FBIopeningUPP/corne-ulp/production/bom.csv

Designator | Footprint | Quantity | Value | LCSC Part #
C1, C101, C104, C105, C4, C5 | 0603 | 6 | 100n
C102, C109, C2, C9 | 0603 | 4 | 2.2uF
C103, C3 | CAP-SMD_L1.6-W0.8-RD | 2 | 4.7uF 6.3V polymer tantalum | C2158419
C106, C107, C6, C7 | 0402 | 4 | 1uF
C108, C8 | 0402 | 2 | 560pF
D1, D101 | SOD-323_L1.7-W1.3-LS2.7-RD | 2 | 1N5819WS | C489147
D10, D102, D103, D104, D105, D106, D107, D108, D109, D11, D110, D111, D112, D113, D114, D115, D116, D117, D118, D119, D12, D120, D121, D122, D13, D14, D15, D16, D17, D18, D19, D2, D20, D21, D22, D3, D4, D5, D6, D7, D8, D9 | SOD-523_L1.2-W0.8-LS1.6-RD | 42 | 1N4148WT-7 | C83482
J1, J101 | FFC-SMD_10P-P0.50_FH34SRJ-10S-0.5SH | 2 | LS011B7DH03_FPC | C324723
OSC1, OSC101 | OSC-SMD_4P-L3.2-W1.5 | 2 | X1B0002110001 | C256005
Q102, Q2 | SOT-23-3_L3.0-W1.7-P0.95-LS2.9-BR | 2 | AO3407 | C351408
R1, R101, R102, R2 | 0402 | 4 | 5.1k
R103, R108, R3, R8 | 0402 | 4 | 100k
R104, R4 | 0402 | 2 | 33.2k
R106, R107, R6, R7 | 0402 | 4 | 820k
SW1, SW10, SW101, SW102, SW103, SW104, SW105, SW106, SW107, SW108, SW109, SW11, SW110, SW111, SW112, SW113, SW114, SW115, SW116, SW117, SW118, SW119, SW12, SW120, SW121, SW13, SW14, SW15, SW16, SW17, SW18, SW19, SW2, SW20, SW21, SW3, SW4, SW5, SW6, SW7, SW8, SW9 | Cherry_ULP_SMD | 42 | Cherry_ULP_SMD
TP1 | TestPoint_Pad_D1.5mm | 1 | L_VDD_SYS
TP101 | TestPoint_Pad_D1.5mm | 1 | R_VDD_SYS
TP102 | TestPoint_Pad_D1.5mm | 1 | R_GND
TP103 | TestPoint_Pad_D1.5mm | 1 | R_SWDIO
TP104 | TestPoint_Pad_D1.5mm | 1 | R_SWDCLK
TP105 | TestPoint_Pad_D1.5mm | 1 | R_RESET
TP106 | TestPoint_Pad_D2.0mm | 1 | R_VBAT
TP107 | TestPoint_Pad_D2.0mm | 1 | R_GND
TP2 | TestPoint_Pad_D1.5mm | 1 | L_GND
TP3 | TestPoint_Pad_D1.5mm | 1 | L_SWDIO
TP4 | TestPoint_Pad_D1.5mm | 1 | L_SWDCLK
TP5 | TestPoint_Pad_D1.5mm | 1 | L_RESET
TP6 | TestPoint_Pad_D2.0mm | 1 | L_VBAT
TP7 | TestPoint_Pad_D2.0mm | 1 | L_GND
U1, U101 | WIRELM-SMD_E73-2G4M08S1C | 2 | E73-2G4M08S1C | C356849
U102, U2 | SOT-23-5_L3.0-W1.7-P0.95-LS2.8-BL | 2 | TP4054 | C32574
U103, U3 | SOT-23-5 | 2 | MIC5219-3.0YM5
USB1, USB101 | USB-C-SMD_SHOU_TYPE-C-16P-CB1.6 | 2 | TYPE-C 16P CB1.6 073 | C2906290
