FBIopeningUPP/corne-ulp/JOURNAL.md

---
title: "aerix-ulp"
author: "I AM LITREALLY FBI"
description: "AERIX-ULP is a low-profile split mechanical keyboard with a custom layout. It is designed around Cherry MX Ultra Low Profile switches and uses a separate wireless controller and battery-powered electronics on each half."
created_at: "2026-11-10"
---

# 2026-11-10: finish

**Total time spent: 1 hr**




design part is done took time but is nice and all and the  keyboard is slim and all and simple witht the enough features

# 2026-11-10: laying out

**Total time spent: 1.5h**



layed out all the components saw some posts on kbd.news saw some keyboard figured out how i will llayout my keys so did it figured out where i place my lcb and what battery i will use and all and figued out how i want my edge cuts to look like and all 





made the schematic nice and all

# 2026-11-10: schematic finished

**Total time spent: 1 hour**





made the default scheamtic i went with nrf52840 and the sharp display as the nicevew and nice nano uses the same and corne ulp as it is the thinnest possible mechancial switches in excistense and tp4054 as it is nice to wire it and many nrf micro like boards ship with it and i went with those already in the pcb like half dipped type type c ports so it stays thin and all i already have designed nrf52840 boards so it was easy and sharp has a nice everything so everything done easily and i have worked on keyboard so the matrix was done fast next i will do the pcb
