FBIopeningUPP/corne-ulp/hardware/split/split.kicad_pcb

## KiCad design hardware/split/split.kicad_pcb (2026-11-10)

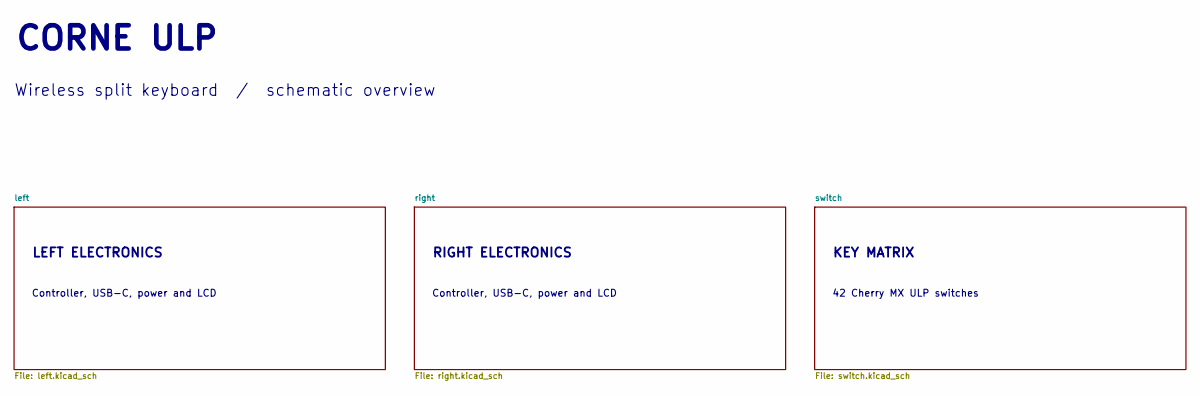
[picture p6: schematic split.kicad_sch]

Notes on the sheet:
Controller, USB-C, power and LCD
CORNE ULP
42 Cherry MX ULP switches
Wireless split keyboard / schematic overview
RIGHT ELECTRONICS
LEFT ELECTRONICS
KEY MATRIX

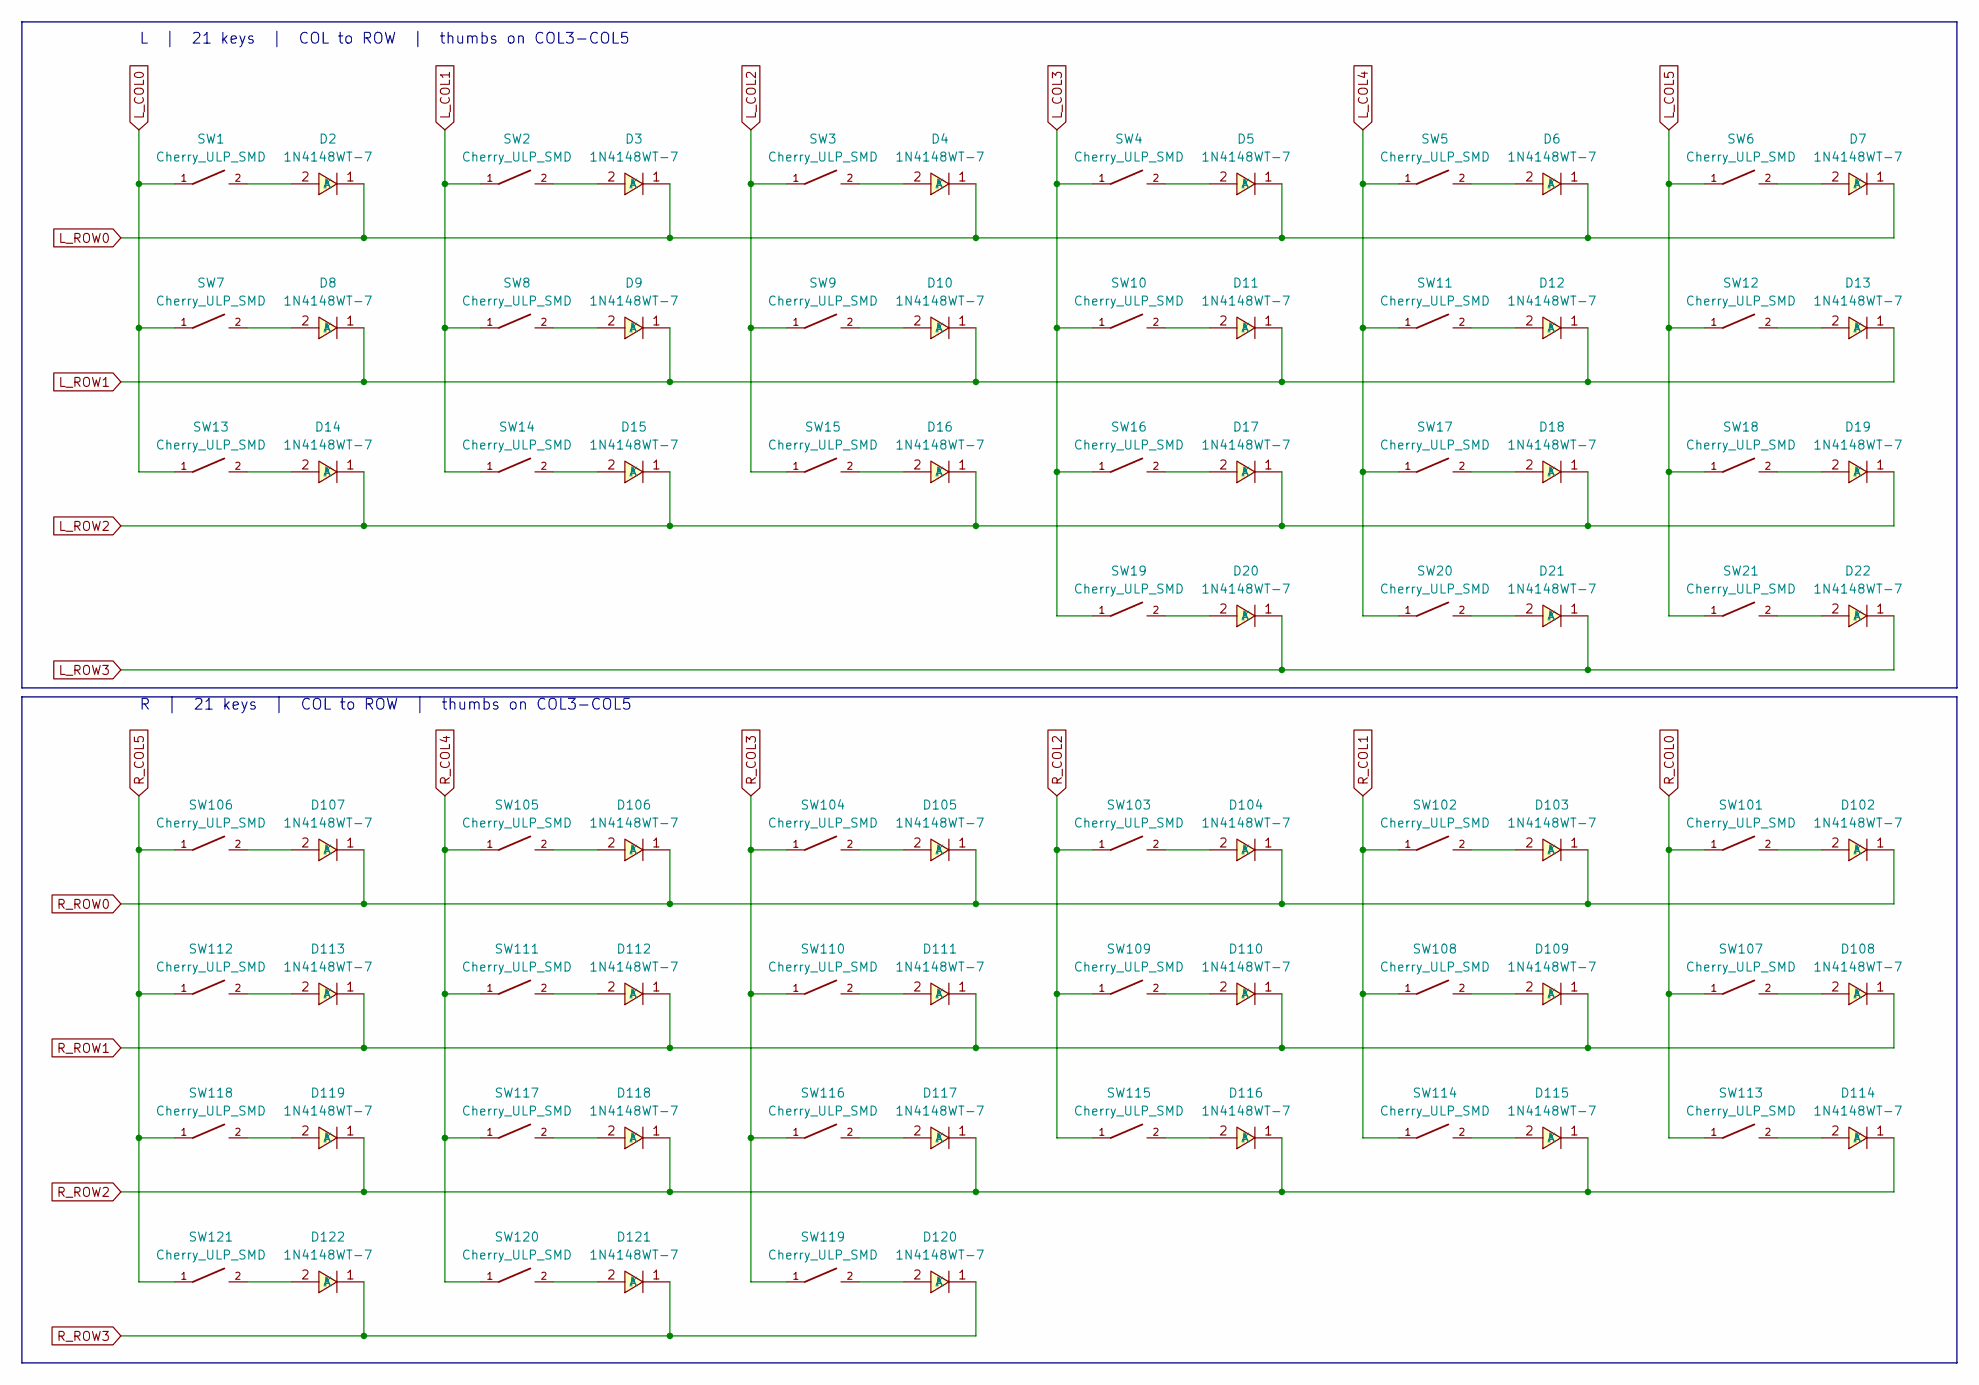
[picture p7: schematic switch.kicad_sch]

Parts:
D2, D3, D4, D5, D6, D7, D8, D9, D10, D11, D12, D13, D14, D15, D16, D17, D18, D19, D20, D21, D22, D102, D103, D104, D105, D106, D107, D108, D109, D110, D111, D112, D113, D114, D115, D116, D117, D118, D119, D120, D121, D122: 1N4148WT-7; SOD-523_L1.2-W0.8-LS1.6-RD
SW1, SW2, SW3, SW4, SW5, SW6, SW7, SW8, SW9, SW10, SW11, SW12, SW13, SW14, SW15, SW16, SW17, SW18, SW19, SW20, SW21, SW101, SW102, SW103, SW104, SW105, SW106, SW107, SW108, SW109, SW110, SW111, SW112, SW113, SW114, SW115, SW116, SW117, SW118, SW119, SW120, SW121: Cherry_ULP_SMD

Connections:
L_COL0: SW1.1, SW7.1, SW13.1; also elsewhere on the board
L_COL1: SW2.1, SW8.1, SW14.1; also elsewhere on the board
L_COL2: SW3.1, SW9.1, SW15.1; also elsewhere on the board
L_COL3: SW4.1, SW10.1, SW16.1, SW19.1; also elsewhere on the board
L_COL4: SW5.1, SW11.1, SW17.1, SW20.1; also elsewhere on the board
L_COL5: SW6.1, SW12.1, SW18.1, SW21.1; also elsewhere on the board
L_ROW0: D2.1 (K), D3.1 (K), D4.1 (K), D5.1 (K), D6.1 (K), D7.1 (K); also elsewhere on the board
L_ROW1: D8.1 (K), D9.1 (K), D10.1 (K), D11.1 (K), D12.1 (K), D13.1 (K); also elsewhere on the board
L_ROW2: D14.1 (K), D15.1 (K), D16.1 (K), D17.1 (K), D18.1 (K), D19.1 (K); also elsewhere on the board
L_ROW3: D20.1 (K), D21.1 (K), D22.1 (K); also elsewhere on the board
unnamed: D2.2 (A), SW1.2
unnamed: D3.2 (A), SW2.2
unnamed: D4.2 (A), SW3.2
unnamed: D5.2 (A), SW4.2
unnamed: D6.2 (A), SW5.2
unnamed: D7.2 (A), SW6.2
unnamed: D8.2 (A), SW7.2
unnamed: D9.2 (A), SW8.2
unnamed: D10.2 (A), SW9.2
unnamed: D11.2 (A), SW10.2
unnamed: D12.2 (A), SW11.2
unnamed: D13.2 (A), SW12.2
unnamed: D14.2 (A), SW13.2
unnamed: D15.2 (A), SW14.2
unnamed: D16.2 (A), SW15.2
unnamed: D17.2 (A), SW16.2
unnamed: D18.2 (A), SW17.2
unnamed: D19.2 (A), SW18.2
unnamed: D20.2 (A), SW19.2
unnamed: D21.2 (A), SW20.2
unnamed: D22.2 (A), SW21.2
unnamed: D102.2 (A), SW101.2
unnamed: D103.2 (A), SW102.2
unnamed: D104.2 (A), SW103.2
unnamed: D105.2 (A), SW104.2
unnamed: D106.2 (A), SW105.2
unnamed: D107.2 (A), SW106.2
unnamed: D108.2 (A), SW107.2
unnamed: D109.2 (A), SW108.2
unnamed: D110.2 (A), SW109.2
unnamed: D111.2 (A), SW110.2
unnamed: D112.2 (A), SW111.2
unnamed: D113.2 (A), SW112.2
unnamed: D114.2 (A), SW113.2
unnamed: D115.2 (A), SW114.2
unnamed: D116.2 (A), SW115.2
unnamed: D117.2 (A), SW116.2
unnamed: D118.2 (A), SW117.2
unnamed: D119.2 (A), SW118.2
unnamed: D120.2 (A), SW119.2
unnamed: D121.2 (A), SW120.2
unnamed: D122.2 (A), SW121.2
R_COL0: SW101.1, SW107.1, SW113.1; also elsewhere on the board
R_COL1: SW102.1, SW108.1, SW114.1; also elsewhere on the board
R_COL2: SW103.1, SW109.1, SW115.1; also elsewhere on the board
R_COL3: SW104.1, SW110.1, SW116.1, SW119.1; also elsewhere on the board
R_COL4: SW105.1, SW111.1, SW117.1, SW120.1; also elsewhere on the board
R_COL5: SW106.1, SW112.1, SW118.1, SW121.1; also elsewhere on the board
R_ROW0: D102.1 (K), D103.1 (K), D104.1 (K), D105.1 (K), D106.1 (K), D107.1 (K); also elsewhere on the board
R_ROW1: D108.1 (K), D109.1 (K), D110.1 (K), D111.1 (K), D112.1 (K), D113.1 (K); also elsewhere on the board
R_ROW2: D114.1 (K), D115.1 (K), D116.1 (K), D117.1 (K), D118.1 (K), D119.1 (K); also elsewhere on the board
R_ROW3: D120.1 (K), D121.1 (K), D122.1 (K); also elsewhere on the board

Notes on the sheet:
L | 21 keys | COL to ROW | thumbs on COL3-COL5
R | 21 keys | COL to ROW | thumbs on COL3-COL5

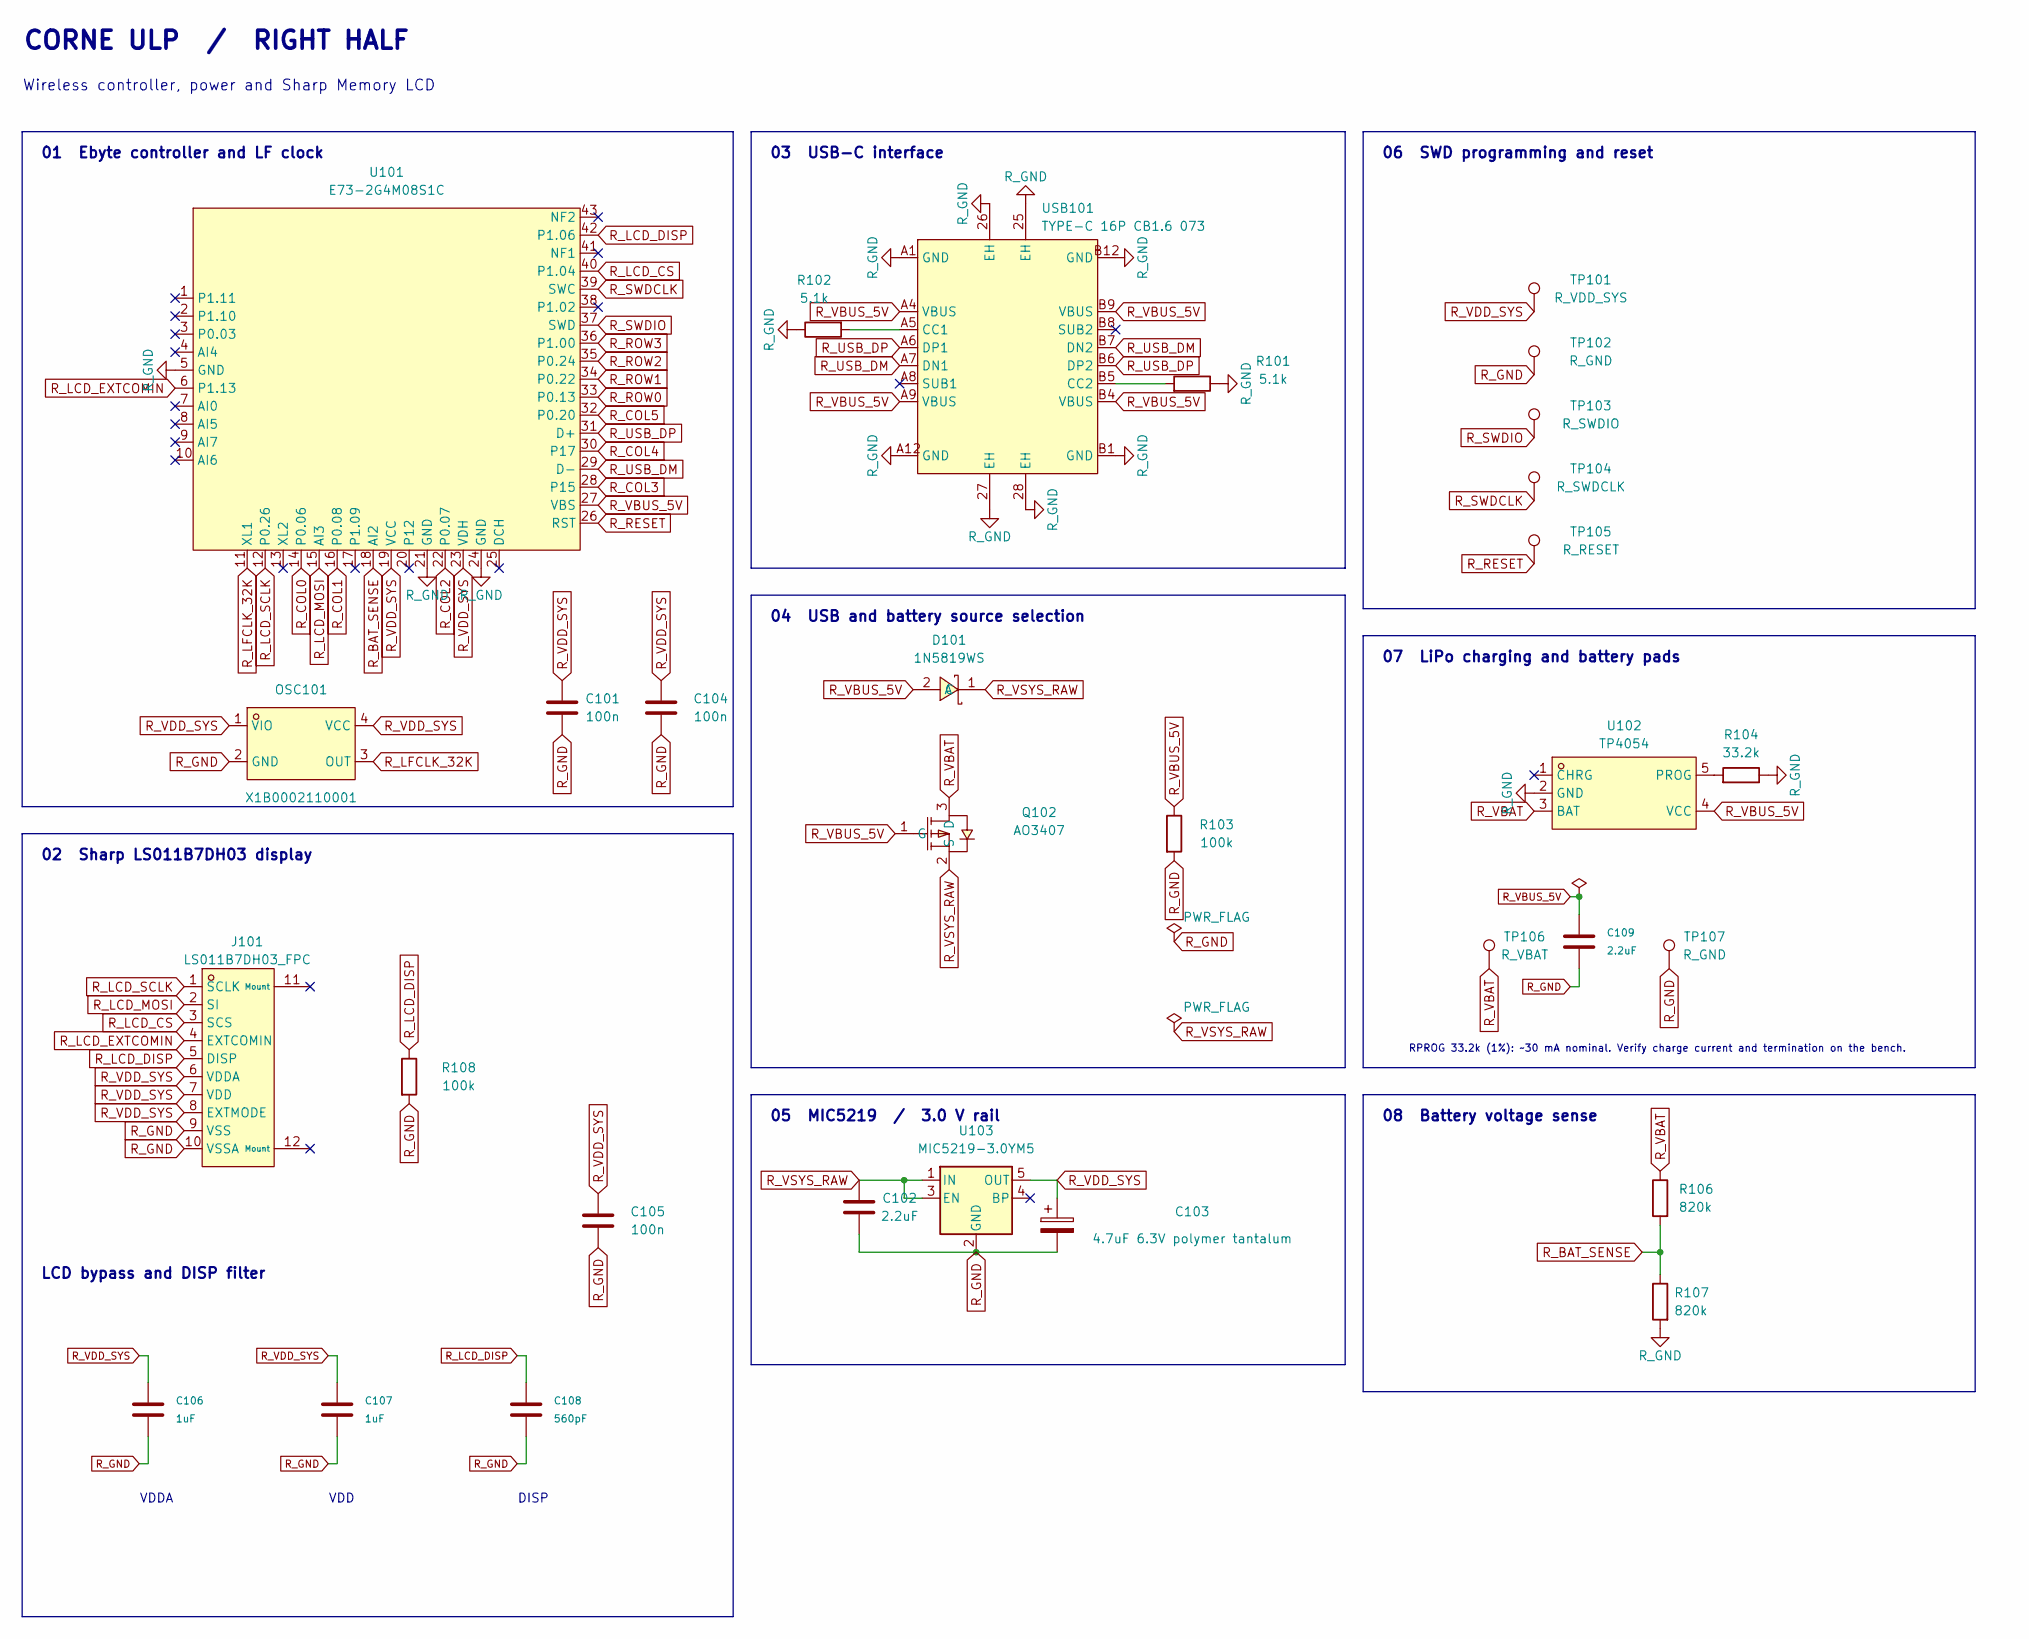
[picture p8: schematic right.kicad_sch]

Parts:
C101, C104, C105: 100n; C_0603_1608Metric
C102, C109: 2.2uF; C_0603_1608Metric
C103: 4.7uF 6.3V polymer tantalum; CAP-SMD_L1.6-W0.8-RD; MPN T55J475M6R3C0500
C106, C107: 1uF; C_0402_1005Metric
C108: 560pF; C_0402_1005Metric
D101: 1N5819WS; SOD-323_L1.7-W1.3-LS2.7-RD
J101: LS011B7DH03_FPC; FFC-SMD_10P-P0.50_FH34SRJ-10S-0.5SH
OSC101: X1B0002110001; OSC-SMD_4P-L3.2-W1.5
Q102: AO3407; SOT-23-3_L3.0-W1.7-P0.95-LS2.9-BR
R101, R102: 5.1k; R_0402_1005Metric
R103, R108: 100k; R_0402_1005Metric
R104: 33.2k; R_0402_1005Metric
R106, R107: 820k; R_0402_1005Metric
TP101: R_VDD_SYS; TestPoint_Pad_D1.5mm
TP102: R_GND; TestPoint_Pad_D1.5mm
TP103: R_SWDIO; TestPoint_Pad_D1.5mm
TP104: R_SWDCLK; TestPoint_Pad_D1.5mm
TP105: R_RESET; TestPoint_Pad_D1.5mm
TP106: R_VBAT; TestPoint_Pad_D2.0mm
TP107: R_GND; TestPoint_Pad_D2.0mm
U101: E73-2G4M08S1C; WIRELM-SMD_E73-2G4M08S1C; MPN E73-2G4M08S1C; LCSC Part C356849
U102: TP4054; SOT-23-5_L3.0-W1.7-P0.95-LS2.8-BL; MPN TP4054-42-SOT25R; LCSC Part C32574
U103: MIC5219-3.0YM5; SOT-23-5
USB101: TYPE-C 16P CB1.6 073; USB-C-SMD_SHOU_TYPE-C-16P-CB1.6; MPN TYPE-C 16P CB1.6 073; LCSC Part C2906290

Connections:
unnamed: R104.1, U102.5 (PROG)
unnamed: R102.1, USB101.A5 (CC1)
unnamed: R101.1, USB101.B5 (CC2)
R_BAT_SENSE: R106.1, R107.2, U101.18 (AI2)
R_COL0: U101.14 (P0.06); also elsewhere on the board
R_COL1: U101.16 (P0.08); also elsewhere on the board
R_COL2: U101.22 (P0.07); also elsewhere on the board
R_COL3: U101.28 (P15); also elsewhere on the board
R_COL4: U101.30 (P17); also elsewhere on the board
R_COL5: U101.32 (P0.20); also elsewhere on the board
R_GND: C101.2, C102.2, C103.2, C104.2, C105.2, C106.2, C107.2, C108.2, C109.2, J101.9 (VSS), J101.10 (VSSA), OSC101.2 (GND), R101.2, R102.2, R103.2, R104.2, R107.1, R108.2, TP102.1 (1_1), TP107.1 (1_1), U101.5 (GND), U101.21 (GND), U101.24 (GND), U102.2 (GND), U103.2 (GND), USB101.25 (EH), USB101.26 (EH), USB101.27 (EH), USB101.28 (EH), USB101.A1 (GND), USB101.A12 (GND), USB101.B1 (GND), USB101.B12 (GND)
R_LCD_CS: J101.3 (SCS), U101.40 (P1.04)
R_LCD_DISP: C108.1, J101.5 (DISP), R108.1, U101.42 (P1.06)
R_LCD_EXTCOMIN: J101.4 (EXTCOMIN), U101.6 (P1.13)
R_LCD_MOSI: J101.2 (SI), U101.15 (AI3)
R_LCD_SCLK: J101.1 (SCLK), U101.12 (P0.26)
R_LFCLK_32K: OSC101.3 (OUT), U101.11 (XL1)
R_RESET: TP105.1 (1_1), U101.26 (RST)
R_ROW0: U101.33 (P0.13); also elsewhere on the board
R_ROW1: U101.34 (P0.22); also elsewhere on the board
R_ROW2: U101.35 (P0.24); also elsewhere on the board
R_ROW3: U101.36 (P1.00); also elsewhere on the board
R_SWDCLK: TP104.1 (1_1), U101.39 (SWC)
R_SWDIO: TP103.1 (1_1), U101.37 (SWD)
R_USB_DM: U101.29 (D-), USB101.A7 (DN1), USB101.B7 (DN2)
R_USB_DP: U101.31 (D+), USB101.A6 (DP1), USB101.B6 (DP2)
R_VBAT: Q102.3 (D), R106.2, TP106.1 (1_1), U102.3 (BAT)
R_VBUS_5V: C109.1, D101.2 (A), Q102.1 (G), R103.1, U101.27 (VBS), U102.4 (VCC), USB101.A4 (VBUS), USB101.A9 (VBUS), USB101.B4 (VBUS), USB101.B9 (VBUS)
R_VDD_SYS: C101.1, C103.1, C104.1, C105.1, C106.1, C107.1, J101.6 (VDDA), J101.7 (VDD), J101.8 (EXTMODE), OSC101.1 (VIO), OSC101.4 (VCC), TP101.1 (1_1), U101.19 (VCC), U101.23 (VDH), U103.5 (OUT)
R_VSYS_RAW: C102.1, D101.1 (C), Q102.2 (S), U103.1 (IN), U103.3 (EN)

Notes on the sheet:
06 SWD programming and reset
VDD
04 USB and battery source selection
LCD bypass and DISP filter
02 Sharp LS011B7DH03 display
08 Battery voltage sense
Wireless controller, power and Sharp Memory LCD
01 Ebyte controller and LF clock
VDDA
03 USB-C interface
DISP
RPROG 33.2k (1%): ~30 mA nominal. Verify charge current and termination on the bench.
CORNE ULP / RIGHT HALF
07 LiPo charging and battery pads
05 MIC5219 / 3.0 V rail

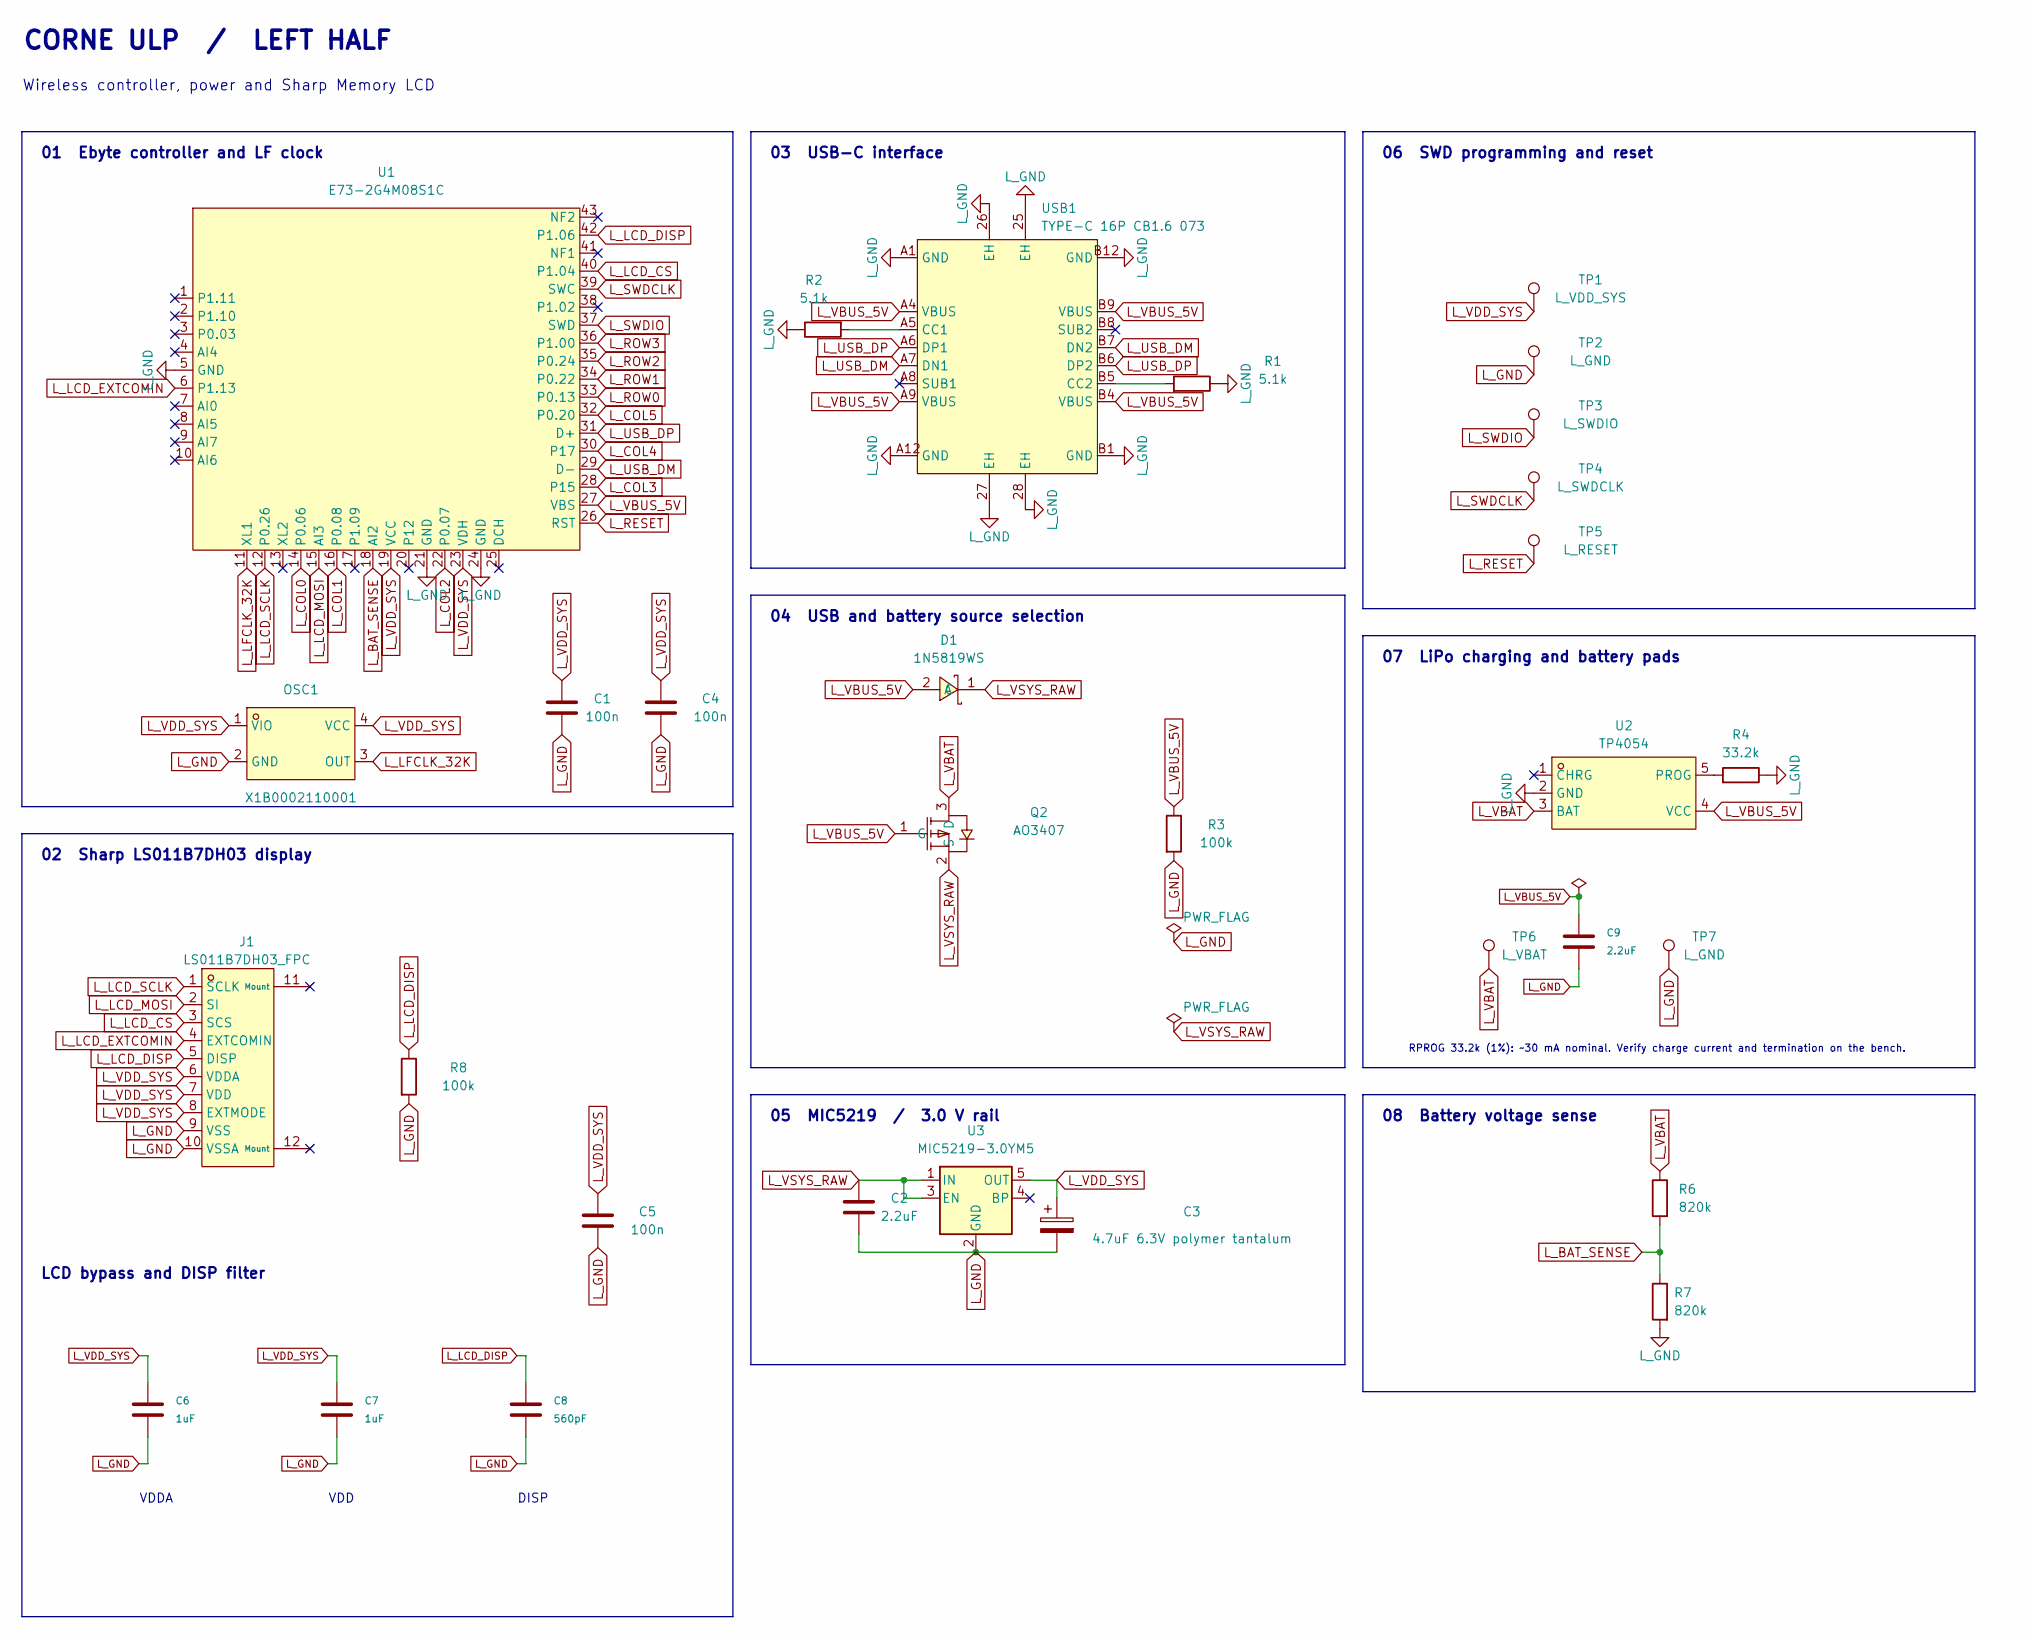
[picture p9: schematic left.kicad_sch]

Parts:
C1, C4, C5: 100n; C_0603_1608Metric
C2, C9: 2.2uF; C_0603_1608Metric
C3: 4.7uF 6.3V polymer tantalum; CAP-SMD_L1.6-W0.8-RD; MPN T55J475M6R3C0500
C6, C7: 1uF; C_0402_1005Metric
C8: 560pF; C_0402_1005Metric
D1: 1N5819WS; SOD-323_L1.7-W1.3-LS2.7-RD
J1: LS011B7DH03_FPC; FFC-SMD_10P-P0.50_FH34SRJ-10S-0.5SH
OSC1: X1B0002110001; OSC-SMD_4P-L3.2-W1.5
Q2: AO3407; SOT-23-3_L3.0-W1.7-P0.95-LS2.9-BR
R1, R2: 5.1k; R_0402_1005Metric
R3, R8: 100k; R_0402_1005Metric
R4: 33.2k; R_0402_1005Metric
R6, R7: 820k; R_0402_1005Metric
TP1: L_VDD_SYS; TestPoint_Pad_D1.5mm
TP2: L_GND; TestPoint_Pad_D1.5mm
TP3: L_SWDIO; TestPoint_Pad_D1.5mm
TP4: L_SWDCLK; TestPoint_Pad_D1.5mm
TP5: L_RESET; TestPoint_Pad_D1.5mm
TP6: L_VBAT; TestPoint_Pad_D2.0mm
TP7: L_GND; TestPoint_Pad_D2.0mm
U1: E73-2G4M08S1C; WIRELM-SMD_E73-2G4M08S1C; MPN E73-2G4M08S1C; LCSC Part C356849
U2: TP4054; SOT-23-5_L3.0-W1.7-P0.95-LS2.8-BL; MPN TP4054-42-SOT25R; LCSC Part C32574
U3: MIC5219-3.0YM5; SOT-23-5
USB1: TYPE-C 16P CB1.6 073; USB-C-SMD_SHOU_TYPE-C-16P-CB1.6; MPN TYPE-C 16P CB1.6 073; LCSC Part C2906290

Connections:
L_BAT_SENSE: R6.1, R7.2, U1.18 (AI2)
L_COL0: U1.14 (P0.06); also elsewhere on the board
L_COL1: U1.16 (P0.08); also elsewhere on the board
L_COL2: U1.22 (P0.07); also elsewhere on the board
L_COL3: U1.28 (P15); also elsewhere on the board
L_COL4: U1.30 (P17); also elsewhere on the board
L_COL5: U1.32 (P0.20); also elsewhere on the board
L_GND: C1.2, C2.2, C3.2, C4.2, C5.2, C6.2, C7.2, C8.2, C9.2, J1.9 (VSS), J1.10 (VSSA), OSC1.2 (GND), R1.2, R2.2, R3.2, R4.2, R7.1, R8.2, TP2.1 (1_1), TP7.1 (1_1), U1.5 (GND), U1.21 (GND), U1.24 (GND), U2.2 (GND), U3.2 (GND), USB1.25 (EH), USB1.26 (EH), USB1.27 (EH), USB1.28 (EH), USB1.A1 (GND), USB1.A12 (GND), USB1.B1 (GND), USB1.B12 (GND)
L_LCD_CS: J1.3 (SCS), U1.40 (P1.04)
L_LCD_DISP: C8.1, J1.5 (DISP), R8.1, U1.42 (P1.06)
L_LCD_EXTCOMIN: J1.4 (EXTCOMIN), U1.6 (P1.13)
L_LCD_MOSI: J1.2 (SI), U1.15 (AI3)
L_LCD_SCLK: J1.1 (SCLK), U1.12 (P0.26)
L_LFCLK_32K: OSC1.3 (OUT), U1.11 (XL1)
L_RESET: TP5.1 (1_1), U1.26 (RST)
L_ROW0: U1.33 (P0.13); also elsewhere on the board
L_ROW1: U1.34 (P0.22); also elsewhere on the board
L_ROW2: U1.35 (P0.24); also elsewhere on the board
L_ROW3: U1.36 (P1.00); also elsewhere on the board
L_SWDCLK: TP4.1 (1_1), U1.39 (SWC)
L_SWDIO: TP3.1 (1_1), U1.37 (SWD)
L_USB_DM: U1.29 (D-), USB1.A7 (DN1), USB1.B7 (DN2)
L_USB_DP: U1.31 (D+), USB1.A6 (DP1), USB1.B6 (DP2)
L_VBAT: Q2.3 (D), R6.2, TP6.1 (1_1), U2.3 (BAT)
L_VBUS_5V: C9.1, D1.2 (A), Q2.1 (G), R3.1, U1.27 (VBS), U2.4 (VCC), USB1.A4 (VBUS), USB1.A9 (VBUS), USB1.B4 (VBUS), USB1.B9 (VBUS)
L_VDD_SYS: C1.1, C3.1, C4.1, C5.1, C6.1, C7.1, J1.6 (VDDA), J1.7 (VDD), J1.8 (EXTMODE), OSC1.1 (VIO), OSC1.4 (VCC), TP1.1 (1_1), U1.19 (VCC), U1.23 (VDH), U3.5 (OUT)
L_VSYS_RAW: C2.1, D1.1 (C), Q2.2 (S), U3.1 (IN), U3.3 (EN)
unnamed: R4.1, U2.5 (PROG)
unnamed: R2.1, USB1.A5 (CC1)
unnamed: R1.1, USB1.B5 (CC2)

Notes on the sheet:
DISP
01 Ebyte controller and LF clock
VDD
06 SWD programming and reset
VDDA
07 LiPo charging and battery pads
LCD bypass and DISP filter
02 Sharp LS011B7DH03 display
08 Battery voltage sense
RPROG 33.2k (1%): ~30 mA nominal. Verify charge current and termination on the bench.
04 USB and battery source selection
Wireless controller, power and Sharp Memory LCD
CORNE ULP / LEFT HALF
03 USB-C interface
05 MIC5219 / 3.0 V rail

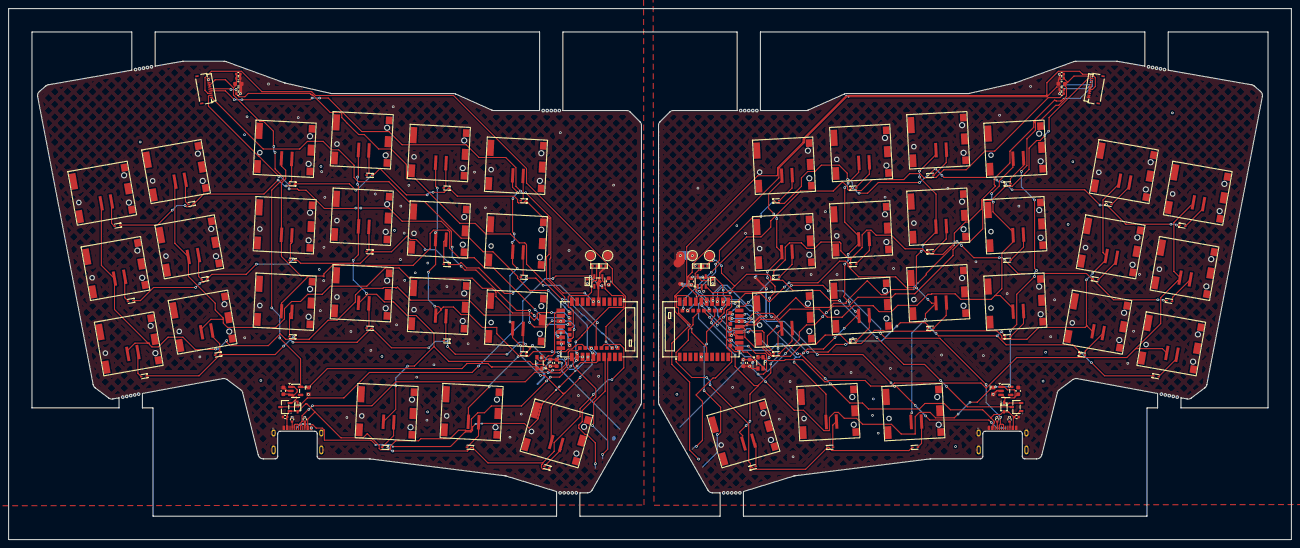
[picture p10: board split.kicad_pcb from above]

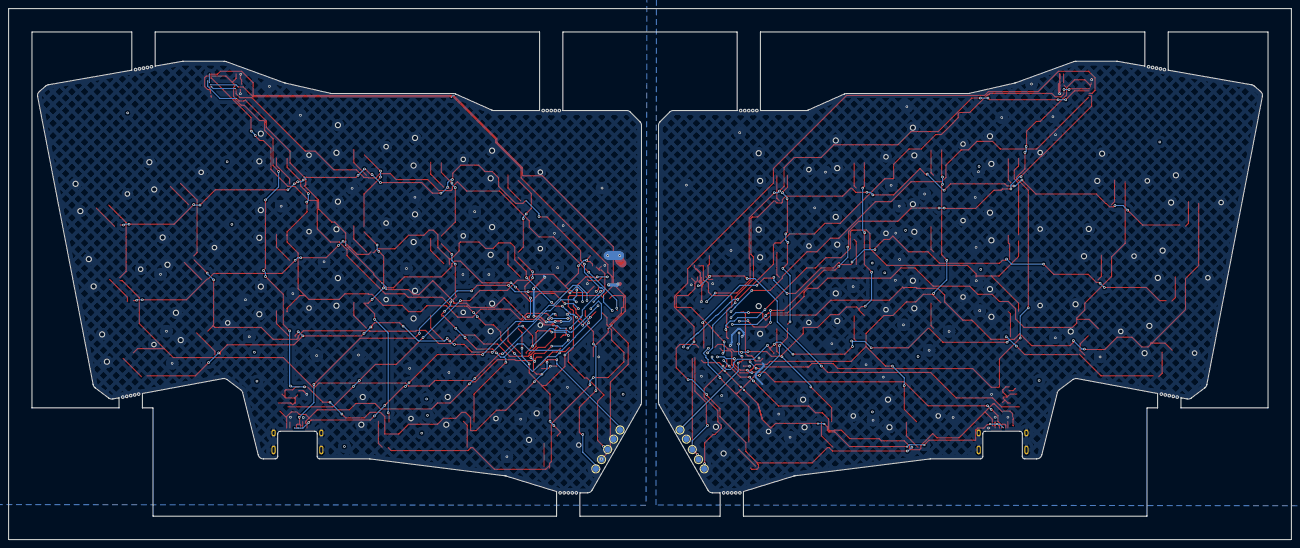
[picture p11: board split.kicad_pcb from below]

Board: 2 copper layers, 302.0 x 125.0 mm, 154 parts (10 on the bottom side), 102 nets.

Other parts of the board:
MB1, MB2, MB3, MB4, MB5, MB6, MB7, MB8: Panel_MouseBite_5x0.6_P0.95
