FBIopeningUPP/corne-ulp/(commit log)

2026-11-10 staring out
    [left.kicad_sch, right.kicad_sch, split.kicad_pcb, split.kicad_sch]
2026-11-10 scheamtic done
    [left.kicad_sch, right.kicad_sch, split.kicad_sch, switch.kicad_sch]
2026-11-10 scheamatic done
    [left.kicad_sch, right.kicad_sch, switch.kicad_sch]
2026-11-10 pcb design will lay everyhing out
    [split.kicad_pcb]
2026-11-10 routing and all
    [left.kicad_sch, right.kicad_sch, split.kicad_pcb, split.kicad_sch, switch.kicad_sch]
